physicsexamlab/dopplercart/(commit log)

2026-04-01 Add WIRELESS_RMS_START cmd and packet ACK mechanism
    - Send [0x37, 0x01, 0x00] to device service cmd char on connect
    - Subscribe to device service recv char for responses
    - Subscribe to both pos 0003 and 0004 chars
    - ACK periodic packets (data[0] <= 0x1F) by writing to pos 0005 char
2026-04-01 Fix: use GCMD_READ_ONE_SAMPLE [0x05,0x02] for position data
    Based on pasco-ble library analysis:
    - Smart Cart does NOT auto-stream; requires [0x05, 0x02] request per sample
    - Response format on 0003 char: [0xC0, 0x00, 0x05, lo, hi]
    - RawCountChange = int16LE(lo, hi), DataSize=2 (from datasheets.js)
    - Position = countAccumulated * 0.09895 / 816
    - sampleTick() now sends [0x05, 0x02] every 50ms
    - handlePositionNotify handles both one-shot and periodic formats
2026-04-01 Route dev recv notifications to handlePositionNotify
    Smart Cart sends all [0xC0,0x00,0x05,lo,hi] responses on device
    service recv char (4a5c0000-0003), not position service (4a5c0003-0003).
    Forward dev recv events to handlePositionNotify to decode position.
2026-04-01 Add combined Smart Cart + ESP32 freq sensor monitor (doppler.html)
    - Dual BLE: Connect Smart Cart (PASCO) + Connect Freq Sensor (ESP32) independently
    - ESP32 timestamp correction: t_recv - 37ms → sampling window center
    - Packet gap detection via ESP32 internal clock diff (>180ms = gap_ok:false)
    - Frequency chart (3rd canvas, orange) added alongside position/velocity
    - Linear interpolation merge: pos/vel interpolated at each freq timestamp
    - CSV: elapsed_s, pos_m, vel_ms, freq_hz, gap_ok (freq-first) or pos-only fallback
2026-04-01 Fix freq elapsed_s to use ESP32 internal clock (eliminate BLE jitter)
    - elapsed_s now computed as t_esp_s - firstFreqEspTime instead of
    browser receive time, removing ±15ms BLE connection interval jitter
    - t_true_ms (browser time) retained for position linear interpolation
    - firstFreqEspTime reset on startRecording() and resetAll()
2026-04-01 Fix CSV vel_ms: recompute from interpolated pos differences
    Previously vel_ms was interpolated from posSession velocities,
    causing inconsistency with the interpolated pos_m values.
    Now vel_ms = Δpos_m / Δelapsed_s using adjacent merged rows.
2026-04-01 Fix velocity: compute from notify arrival time instead of sampleTick timer
    Previously vel was calculated in sampleTick() using the 50ms timer
    timestamps, causing spikes when notify arrival and timer were misaligned.
    Now vel is computed in handlePositionNotify() using actual notify
    arrival times (Δpos / Δt), and sampleTick() reads latestVelocity directly.
2026-04-01 Fix CSV vel dip: interpolate vel_ms from posSession instead of Δpos/Δt
    When interpolated pos didn't change between freq samples (no notify
    in that window), Δpos/Δt produced false zero dips in vel_ms.
    Now vel_ms is interpolated directly from posSession.vel_ms which is
    computed at notify arrival time, avoiding the zero-dip artifact.
2026-04-01 Fix vel spikes: ignore notify dt < 20ms (devRecv/char0003 double-fire)
    Two BLE notify channels (devRecv + char0003) can deliver packets
    within 1-2ms of each other, causing dt≈0.002s and vel spikes of
    ±30 m/s. Now velocity is only updated when dt >= 20ms, treating
    sub-20ms arrivals as duplicate notifications.
2026-04-01 Fix CSV vel: use Δpos/Δt of interpolated pos, carry prev vel when Δpos≈0
    vel_ms now equals Δpos_m/Δt so pos and vel are numerically consistent.
    When interpolated pos is unchanged (no notify in window), the previous
    vel is carried forward to avoid zero dips.
2026-04-09 Fix CSV vel spikes/sticking: centered finite diff ±3pts; add amplitude column
    - Replace adjacent-point vel (60ms, carry-prev-on-zero) with ±3-point
    centered finite difference (~360ms window) to smooth notify jitter
    - Remove carry-prev-vel logic: Δpos=0 now correctly yields vel=0
    - Parse optional 3rd BLE field as amplitude in onFreqNotify/freqSession
    - CSV header: elapsed_s,pos_m,vel_ms,freq_hz,amplitude,gap_ok
2026-04-09 N=1600: double Goertzel window for better freq resolution
    - doppler-cart.ino: N 800→1600 (~110ms window @ 14.5kHz)
    - doppler.html: SAMPLING_TAIL_MS 37→67ms, FREQ_GAP_THRESHOLD_MS 180→360ms
2026-04-10 Reduce vel smoothing window: HALF_WIN 3→1 for better instantaneous velocity
    HALF_WIN=3 (±0.33s) averaged out rapid oscillations (~1Hz hand push),
    causing vel_ms to appear near-zero during actual fast motion.
    HALF_WIN=1 (±0.11s) better tracks instantaneous velocity.
2026-04-11 v5: Add AMPLITUDE_MIN for MAX9814, enable Serial output
    - Add AMPLITUDE_MIN=30.0f threshold (calibrate after MAX9814 connection)
    Fixes: audio-off noise passing MIN_PP check and generating spurious freq
    - freq_hz=-1 now when pp<MIN_PP OR amplitude<AMPLITUDE_MIN
    - Re-enable Serial.println for connection verification and calibration
    - Update comments for MAX9814 wiring (GAIN→VDD for 60dB, open for 40dB)
    [doppler-cart.ino]
2026-04-11 Fix MAX9814 GAIN pin comment: open=60dB (not 40dB)
    Per datasheet: GAIN=open→60dB, GND→50dB, VDD→40dB.
    Previous comment had it backwards.
    [doppler-cart.ino]
2026-04-11 Raise AMPLITUDE_MIN 30→50: noise floor max=28, need margin
    MAX9814 60dB measured: noise floor 2-28 counts, signal 460-610 counts.
    30 was too close to noise max (27.74). 50 gives comfortable margin.
    [doppler-cart.ino]
2026-04-19 Add amplitude filter, velocity smoothing, and Doppler scatter plot
    - doppler_55ms.html: amplitude threshold slider (default 100), 5-point
    trailing average for velocity display, scatter plot panel (v vs. Δf)
    with theoretical curve and auto-computed f₀
    - analyze_doppler.py: offline scatter plot analysis across 4 runs,
    amplitude threshold sweep (50/100/150/200)
    - Add scatter PNG outputs from 4-run dataset
2026-04-20 Add encoder reset to Reset button: BLE [0x05,0x01] + post-reset jump filter
2026-04-20 Improve measurement reliability: amplitude filter, continuity check, phase slip watchdog
    - AMPLITUDE_MIN 50→80 (firmware): eliminates spurious values from low-SNR zone
    - freq_scan continuity check (8Hz/frame threshold): rejects false room-mode peaks
    - Phase slip watchdog (5Hz scan-vs-phase threshold): detects and clears 2π slips
    - JS safety net: same filters applied client-side for legacy firmware compatibility
    - Chart: low-confidence freq_phase points (amp < 2×threshold) shown as gray dots
    [doppler-cart.ino]
2026-04-20 Revert firmware logic additions: keep only AMPLITUDE_MIN 50→80
    Continuity check and phase-slip watchdog removed from .ino to eliminate
    potential crash source. These filters remain active in JS (doppler-phase.html).
2026-04-20 Remove per-frame Serial output from loop()
2026-04-20 Split amplitude threshold: SCAN=80, PHASE=40
    Phase method derives frequency from phase difference Δφ, not peak amplitude.
    Lower threshold exploits its robustness to amplitude fading.
2026-04-20 Add physical range filter for freq_phase: |freq_phase - fc| > 10 Hz → -1
    Catches phase slips when freq_scan is also -1 (watchdog blind spot).
    10 Hz corresponds to v ≈ 3.4 m/s, beyond typical cart speed.
2026-04-20 Tighten physical range filter: 10 Hz → 6 Hz (v ≈ 2.1 m/s)
2026-04-21 Fix vel_ms accuracy: use BLE-timed velocity instead of position diff
    - buildCsv(): replace HWIN=1 position-difference recomputation with
    p.vel_ms from interpolatePos(), which reflects BLE arrival-timed
    velocity — eliminates spikes from stale/duplicate position packets
    - drawScatter(): same fix for both scan and phase scatter points
    (removed HALF_WIN=2 position-diff, now uses pi.vel_ms directly)
    - handlePositionNotify(): detect seq number gaps (mod-32) and log
    dropped PASCO BLE packets to Diagnostic Log
    - Track lastPositionNotifyMs on every position notify (stale detection
    groundwork)
2026-04-21 Revert vel_ms to position diff with HWIN=3 (330ms window)
    BLE-timing velocity (Fix 1) caused worse spikes (up to -4.45 m/s)
    due to burst packet arrivals with short Δt. Position diff over ±3
    frames (330ms) averages out stale/repeated positions while staying
    within physically reasonable bounds.
2026-04-21 Stabilize phase tracking and fix HTML amplitude gating
    ino changes:
    - TRACKING中の81点スキャンを停止（SCANNING/CAL_PHASEのみ実行）
    - TRACKING時のamplitudeをIQ振幅に切り替えてBLE送信
    - HOLD_MAX超過でCAL_PHASEに戻らずφチェーンリセット+f_estホールド継続
    - BLEコメントを8フィールド仕様に修正、TRACKINGの動作説明を実装と整合
    html changes (v2):
    - Scan/Phase振幅閾値を分離（scanAmpThreshold=100, phaseAmpThreshold=10）
    - gap_okをisScanPointUsable/isPhasePointUsableに統合
    - estimateStaticPhaseOffsetHzに速度フィルタ(|v|<0.08)を追加しΔφ₀診断を改善
    - amplitudeラベルをTRACKING時は"IQ amp"と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
2026-04-22 Fix PLL drift bug and add time axis to charts
    PLL: replace absolute phase wrap_pi(phi) with frame-to-frame dphi
    = wrap_pi(phi - prev_phi), converting to freq_error via 2π×T_el.
    Drops PI loop (KP/KI) in favor of simple IIR (PLL_ALPHA=0.20) per
    original design intent. Eliminates spurious f_est drift while stationary.
    HTML: add second-tick time axis to position, velocity, and frequency
    charts. Data plotted on time-linear x-axis using parallel elapsed_s
    arrays (posTimeValues / freqTimeValues).
2026-04-23 Add simplified PLL firmware and fix HTML reference-line inconsistencies
    New files:
    - Arduino/doppler-cart-phase-simple/doppler-cart-phase-simple.ino
    v3 PLL: Goertzel probes f_est (not fc), no Goertzel calibration scan,
    nominal 1000 Hz start, NCO phase continuity across frames.
    - doppler-phase-simple.html
    Companion UI: auto-zeros f_c from static interval via Smart Cart velocity.
    Bug fixes in doppler-phase-simple.html:
    - Freq chart reference line now uses getReferenceFc() (= derivedFc when
    available) instead of lastFc (firmware nominal 1000 Hz), so it matches
    the scatter plot's Δf=0 baseline.
    - freq_phase range check now uses freq_pll as reference when PLL is lock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
2026-04-24 Add files via upload
    低振幅の freq_pll をそのまま採用・描画しない安全網
2026-04-25 Improve doppler_55ms.html: shared time axis, Goertzel quality fixes
    - Add drawTimeAxis() and shared-time-axis label below freq chart,
    matching doppler-phase-simple.html layout
    - Track posTimeValues/freqTimeValues rolling buffers; pass to all
    three chart draw calls (pos, vel, freq) so x-axis shows elapsed_s
    - Raise AMPLITUDE_MIN threshold to 100 to match HTML slider default
    and suppress spurious outlier reads (980 Hz, 1009 Hz) from low-SNR windows
    - Compute t_esp_s at window midpoint (t0+t1)/2 instead of post-Goertzel
    micros(); set SAMPLING_TAIL_MS=0 accordingly
    - Add NimBLEDevice::setPower(ESP_PWR_LVL_P9) for BLE range
    - Wrap Serial.println under #define DEBUG_SERIAL 0
    - Add gap_ok c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
2026-04-25 Fix velocity quality in doppler_55ms.html to match phase-simple
    - SAMPLING_TAIL_MS: 0 → 37ms
    - CSV_VEL_HALF_WIN: 1 → 3 (±3 frames ≈ 330ms window)
    - t_true_ms: use firstFreqRecvMs + elapsed_s*1000 anchor to eliminate
    BLE jitter, consistent with doppler-phase-simple.html approach
    - Add firstFreqRecvMs state variable with proper resets
2026-04-25 Add amplitude²-weighted frequency averaging to chart, stats, and CSV
    - computeWeightedFreq(): amplitude²-weighted mean over ±FREQ_W_HALF_WIN(=3) frames
    - drawFreqChart(): raw freq as faint line, weighted avg as bold line (replaces drawChart call)
    - CSV: add freq_w_hz column (central ±3 window, matching vel_ms window)
    - Display stats: show weighted freq instead of raw last value
    - resetAll(): clear freqWValues buffer
2026-04-26 Sync position sampling to ESP32 timestamp in onFreqNotify
    posSession was previously populated by setInterval(55ms), causing
    t_ms to reflect browser poll time rather than when the Smart Cart
    position was actually measured. This mismatch introduced timing
    jitter into interpolatePos, making differentiated velocity noisy.
    Now posSession is pushed inside onFreqNotify using t_true_ms (ESP32
    internal clock, BLE-jitter-corrected), so position and frequency
    share the same timebase. sampleTick is reduced to a keepalive-only
    0x05/0x02 write for the Smart Cart stream.
2026-04-26 Record posSession event-driven from handlePositionNotify
    The previous fix moved posSession sampling into onFreqNotify, which
    correctly aligned timestamps to the ESP32 clock but did not fix the
    zigzag velocity problem. The root cause was that latestPosition does
    not change when the Smart Cart sends no notification in a 55ms window,
    causing alternating zero/double-size position jumps (~19% of frames).
    Now posSession is populated inside handlePositionNotify using the BLE
    notification arrival time (performance.now()) as the timestamp. This
    gives one posSession entry per actual Smart Cart position update, at
    the true measurement time. interpolatePos then correctly interpolates
    between these even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
2026-04-26 Exclude Goertzel boundary hits from freq weighted average; add devlog
    computeWeightedFreq now skips frames where freq_hz is at or beyond
    the Goertzel search range boundaries (960 Hz / 1040 Hz). These
    boundary-pinned values are spurious hits that occur at low amplitude
    and can inflate the window spread by up to 54 Hz, even though amp²
    weighting already suppresses their contribution significantly.
    Also adds GOERTZEL_FREQ_LOW/HIGH constants matching Arduino firmware,
    and DEVLOG_2026-04-26.md summarising today's signal quality work and
    two-stage position timestamp synchronisation fixes.
2026-04-26 Use freq_w_hz in scatter plot and on resize/slider redraw
    Three fixes:
    1. drawScatter: Δf was computed from raw f.freq_hz. Now uses
    computeWeightedFreq(..., FREQ_W_HALF_WIN) so scatter points
    reflect the smoothed, outlier-suppressed frequency. Frames with
    no valid weighted average (fw <= 0) are skipped.
    2. resizeCanvases: was calling drawChart(freqValues) which only
    rendered raw freq_hz without the weighted overlay. Now calls
    drawFreqChart(freqValues, freqWValues, ...) matching the
    real-time rendering path.
    3. ampSlider handler: rebuilt freqValues/freqTimeValues but not
    freqWValues, then called drawChart instead of drawFreqChart.
    Now rebuilds all three buffers usi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
2026-04-27 Fix 7 bugs in doppler-cart-n800 firmware and doppler_55ms HTML monitor
    Firmware (doppler-cart-n800.ino):
    - Boundary-hit fix: bestB at bin 0 or N_BINS-1 now returns freq_hz=-1
    instead of outputting FREQ_LOW/FREQ_HIGH as if valid
    HTML (doppler_55ms.html):
    - Remove undeclared `notifyPacketCount` variable from resetAll()
    - Fix SAMPLING_TAIL_MS comment inconsistency (≈40ms → ≈37ms)
    - computeFRef() fallback: use median of all valid freqs instead of
    hardcoded 997.0 when no stationary data is available
    - Scatter plot: apply ampThreshold to gap_ok=false points (were shown
    red regardless of amplitude; now faint gray below threshold)
    - Standardize amplitude null-guard from `|| 0` to `?? 0`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
2026-04-27 Fix TypeError crash in connectSmartCart() after diagLog element removal
    document.getElementById('diagLog').textContent was called without a null
    check, but the diagLog element was removed from the HTML in a876047.
    This caused a TypeError on button click, preventing the BLE pairing
    dialog from appearing.
2026-04-27 Add doppler_55ms_spectrum.html: binary Goertzel spectrum receiver
    New companion HTML for the upcoming doppler-cart-n800-spectrum.ino
    firmware, which sends the full 81-bin Goertzel magnitude spectrum
    (960-1040 Hz, 1 Hz steps) over BLE on every 55 ms cycle to debug
    frequency-estimation outliers.
    Wire format (178 B per notify, little-endian):
    0..3 float32 t_esp_s (window-center seconds)
    4..7 float32 freq_hz (-1.0 if invalid)
    8..11 float32 amplitude
    12..15 float32 mag_scale (1 LSB of mag_q[] in mag units)
    16..177 uint16[81] mag_q (mag[b] = mag_q[b] * mag_scale)
    mag_scale is recomputed each frame as max(mag)/65535 so the uint16
    range tracks th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
2026-04-28 Record freq and pos timestamps separately in spectrum CSV
    - CSV now writes freq_t_s (window midpoint, SAMPLING_TAIL-corrected)
    and pos_t_s (BLE arrival, uncorrected) as separate columns so the
    freq vs pos timing alignment can be validated offline
    - pos column uses the nearest pos sample (no interpolation onto freq grid)
    - vel_ms is computed from pos's own t_ms central diff (±3 pos samples),
    removing the freq-grid interpolation that acted as a low-pass filter
    - Scatter plot uses the same pos-time central diff for consistency
    - Add nearestPosIdx() and posCentralDiffVel() helpers
2026-04-28 Sync pos polling to freq notify; widen vel window to fix slope bias
    - onFreqNotify now triggers [0x05,0x02] pos poll on every freq packet
    arrival, replacing the independent setInterval(55ms) as the primary
    polling source. This eliminates setInterval timer jitter (measured
    std=23ms) so pos_t_s becomes freq_recv_t + BLE_RTT (a near-constant
    offset), enabling future SAMPLING_TAIL_MS calibration.
    - sampleTick() now no-ops when freq sensor is connected; it remains as
    a fallback for cart-only mode (freq sensor absent).
    - CSV_VEL_HALF_WIN: 3 -> 6. Re-fit analysis on apr28_2.csv showed that
    the -9% slope deficit (2.65 vs theoretical 2.91 Hz/(m/s)) is caused by
    freq-vel time misalignme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
2026-04-28 Add SAMPLING_TAIL_MS in-browser calibration (τ-scan)
    Stop 後に τ ∈ [-80,+80] ms を 2 ms 刻みでスキャンし、
    v vs Δf の Doppler 線形フィット R² を最大化する τ_opt を求める。
    結果を calibPanel に表示し「適用」ボタンで samplingTailAdjMs を設定、
    drawScatter / buildCsv の freq-pos 時刻マッチングに即時反映する。
    ・calibrateSamplingTail(): τスキャン + 線形回帰 (nPts≥10 のみ採点)
    ・showCalibResult(): τ_opt / 推奨 SAMPLING_TAIL / R² / slope/理論 を表示
    ・stopRecording(): 自動校正呼び出し追加
    ・resetAll(): samplingTailAdjMs=0 + panel 非表示
    ・buildCsv() / drawScatter(): adjTrueMs = t_true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
2026-04-28 Replace nearestPosIdx with linear interpolation for freq-pos matching
    pos_m と vel_ms を freq_t_true 前後 2 点の線形補間に変更。
    nearestPosIdx（最近傍選択）を削除し interpolatePos(t, halfWin) に統一。
    pos_t の ±24ms BLE RTT ジッターによる Doppler slope 誤差を軽減する。
2026-04-28 Fix calibrateSamplingTail: revert to nearestPosIdx for tau scan
    interpolatePos(halfWin=6) は ±180ms 平均速度を返すため、
    ±80ms の τ スキャンで速度がほぼ変化せず R² が flat になり
    境界値 (+80ms) に張り付く問題があった。
    calibrateSamplingTail 専用に nearestPosIdx を復元し、
    posCentralDiffVel(k, HALF) を使う元の方式に戻す。
    drawScatter / buildCsv は引き続き interpolatePos を使用。
2026-04-29 Add 2kHz variants: doppler-cart-n800-spectrum-2k.ino and doppler_55ms_spectrum_2k.html
    Goertzel band shifted from 960-1040 Hz to 1960-2040 Hz.
    BLE device name changed to "Doppler Spec Sensor 2k".
    Scatter plot Y-axis widened to ±20 Hz (doubled Doppler shift at same velocity).
    All other logic identical to the 1kHz originals.
2026-04-29 Switch pos to 100Hz burst streaming via 0003-0004
    - Subscribe to POSITION_BURST_CHAR (0003-0004) for high-rate streaming
    - Send rate cmd (01 10 27 00 00 02 00) to set 100Hz before WIRELESS_RMS_START
    - Change 37 01 00 → 37 01 01 to enable streaming mode
    - Replace handlePositionNotify (one-shot poll) with handlePosBurst (burst parser)
    - Add carry-byte buffer to handle odd-byte ATT payloads at 100Hz (20-byte MTU limit)
    - Fix ACK format: 5 bytes [00 00 00 00 seq] matching SPARKvue protocol
    - Remove 05 02 one-shot polling from onFreqNotify and sampleTick
    - Reduce CSV_VEL_HALF_WIN 6 → 3 (pos now 10x denser at 10ms intervals)
    - Remove DUPLICATE_GUARD_MS (no longer needed without one-shot polls)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
2026-04-29 Add start trigger (0x00) to devCmd after WIRELESS_RMS_START
    37 01 01 arms streaming mode but does not start data flow.
    SPARKvue sends 0x00 to devCmd as the actual start trigger,
    after which 0003-0004 burst notifications begin.
2026-04-29 Add 05 10 query and 06 af 05 experiment config before start trigger
    Replicating SPARKvue 100Hz sequence:
    37 01 01 (arm streaming)
    05 10 (pos status query / rate commit)
    06 af 05 (experiment config, value from 100Hz capture)
    00 (start)
    Previous attempts (37 01 01 + 00 alone) produced no 0003-0004 bursts.
2026-04-29 Fix seq wrap: use 5-bit counter (mod 32) not mod 256
    Cart seq is 0x00..0x1f (32-cycle). Using & 0xFF caused
    0x1f→0x00 normal wrap to be reported as 224 lost packets,
    which incorrectly cleared posBurstCarry on every cycle.
2026-04-29 Fix pos timestamp: sequential clock to reduce BLE jitter propagation
    - Replace per-burst t_recv backtrack with sequential lastSampleEndTime+10ms
    - Re-anchor to t_recv only when drift exceeds ±2 sample periods (20ms)
    - Reset sequential clock on seq gap and startRecording/resetAll
    - Clarify posBurstCarry comment: carry is 100Hz-specific (20/50Hz have even payloads)
    - Add warning comment on 06 af 05 middle byte variability (20Hz=ac, 50Hz=ad, 100Hz=af)
2026-04-29 Fix P1: don't reset decoder state at startRecording; add burst watchdog
    P1 (critical): Remove posBurstCarry=[] and lastSampleEndTime=0 from
    startRecording(). Recording start is purely a data-saving boundary —
    the 100Hz burst decoder runs continuously and resetting carry mid-stream
    shifts int16 parsing by 1 byte, corrupting countAccumulated permanently.
    P2b: Add 2s watchdog after start trigger. If lastPacketSeq hasn't
    advanced, log a warning that 06 af 05 middle byte may need adjustment.
2026-04-30 Widen tau scan to ±200ms; warn on rawChange spikes
    calibrateSamplingTail() の探索幅 ±80ms では実測の最適 τ ≈ -130ms を
    拾えず境界に張り付いていたため ±200ms に拡大。
    handlePosBurst() で |rawChange| > 200 cnt/10ms (≈ 2.4 m/s) のときに
    seq / sample index / carry / payload 長を warn 出力し、100Hz burst
    parser の byte misalignment 疑いを切り分けられるようにする。
2026-04-30 Push pos/vel chart at 100Hz from handlePosBurst
    freq notify (~18Hz) で latestPosition / latestVelocity をスナップ
    していたため、pos burst 間隔 (~10Hz, 9-10サンプル/notify) との不整合
    で 1-2 freq frame の値が同じになり、グラフが階段状に見えていた。
    handlePosBurst の per-sample ループで posValues / velValues /
    posTimeValues に直接 push し、バースト末尾で 1 度 drawChart する。
    描画レートはバースト rate (~10Hz) に保ちつつ、サンプル粒度は 100Hz
    となるため、定常運動で滑らかな直線が出るはず。階段が残るなら
    100Hz parser の正しさを疑う段階に進む。
    CSV 経路 (interp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
2026-04-30 Fix stop button: gate 100Hz display push with isRecording
    handlePosBurst chart push block was not guarded by isRecording,
    so charts continued updating after stopRecording() was called.
2026-04-30 Quiet console after Stop; flag BLE stalls; explicit stop log
    - Gate handlePosBurst diagnostic warns (seq gap, clock re-anchor, rawChange
    spike) behind isRecording so the console goes silent after Stop. The BLE
    notify pipe stays subscribed by design, but the unconditional warn flood
    made it look like recording was still active.
    - Suppress normal-jitter re-anchors (≤50ms) and call out |drift|>200ms as
    a distinct "BLE stall" with a counter, so the 1.6s stall-and-burst event
    seen in apr30_4 is unambiguous instead of buried in re-anchor noise.
    - log() "Recording started." / "Recording stopped." with frame counts and
    stall summary, and guard stopRecording() against double-execution.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
2026-04-30 Feature B: per-frame spectral quality metrics + UI indicator + frame filter
    Add sidelobe_ratio and fwhm_hz metrics computed from each Goertzel spectrum
    frame's mag_q array to detect multipath interference in real time.
    - computeSpecQuality(): sidelobe_ratio (secondary peak / primary peak, outside
    ±10 Hz exclusion zone) and fwhm_hz (half-power width of primary peak)
    - updateQualityIndicator(): GOOD/MARGINAL/POOR badge with color, updated every
    freq notify; threshold at sidelobe_ratio < 0.50 / 0.75 / ≥0.75
    - Quality bar UI: real-time badge + sidelobe/FWHM detail + "Filter poor quality"
    checkbox (default OFF)
    - drawScatter(): poor frames (sidelobe ≥ 0.75) rendered as dim orange; whe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
2026-05-01 Fix: Unify graph time axes (t=0 to stop time) and add freq_hz validation
    - Increase MAX_POINTS from 300 to 3000 to prevent data deletion before recording stops
    - Add recordEndTime_s global variable to track recording end time
    - Unify time axis across all three graphs (Position, Velocity, Frequency):
    * Left edge: always t=0 (start of recording)
    * Right edge: recordEndTime_s (time when Stop button pressed)
    - Stop button now redraws all graphs with unified time axis
    - Add mag_idx_max to CSV export: the frequency bin index with maximum magnitude
    * Allows validation of freq_hz values against actual spectral peak
    * Format: frequency value corresponding to the max magnitude bin
    This resolv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
2026-05-01 Fix: Use freq_t_s instead of elapsed_s for frequency graph time axis
    The on-screen frequency graphs were using elapsed_s (ESP32 internal clock)
    as the time axis, while the CSV export used freq_t_s (corrected with
    SAMPLING_TAIL calibration). This mismatch caused:
    1. Visual kinks at t≈2.1s and t≈3.5s where the relationship between
    elapsed_s and actual timing changed
    2. Time coordinate offset: freq_t_s < elapsed_s by ~40-130ms
    Both live drawing (handleFreqNotify) and post-recording rebuildFreqBuffers()
    now calculate freq_t_s = (t_true_ms + samplingTailAdjMs - recordStartTime)/1000
    to match CSV output and provide correct visual alignment.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
2026-05-01 Fix: Align frequency graph time axis with position/velocity graphs
    The frequency graph was using recordStartTime as the time reference, while
    position and velocity graphs used firstFreqRecvMs. This caused a horizontal
    offset between the graphs when recordStartTime and firstFreqRecvMs differed
    (typically 0-500ms apart).
    Changed frequency time axis calculation to use firstFreqRecvMs as the base
    reference (same as position/velocity), ensuring all three graphs display
    on the same unified time scale:
    freq_t_chart_s = (adjTrueMs - firstFreqRecvMs) / 1000
    This affects both live display (handleFreqNotify) and post-recording
    rebuild (rebuildFreqBuffers). CSV export remains independent with
    record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
2026-05-01 Fix: Improve spectral quality filter and τ calibration robustness
    1. QUALITY_EXCLUSION_HZ: 10.0 → 20.0 Hz
    - Hann window main lobe FWHM ≈ 40Hz に対応
    - sidelobe_ratio = 0.82-0.83 の実測値を正しく評価
    - フィルタ動作: 全フレーム除外 → 上位15%のみ除外に改善
    2. calibrateSamplingTail() 改善
    - Adaptive amplitude threshold (中央値の60% or 200)
    - 固定300 hardcode → データ依存的な閾値に改善
    - Quality filter: 0.75 → 0.85 (Hann tail を超える不良のみ除外)
    - τ calibration が amplitude に依存しすぎる問題を軽減
    Result:
    - may1_5.csv で "Filter poor quality" が正常に機能
    - τ run-depen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
2026-05-01 Feature: Per-session τ auto-calibration and reset
    1. UI: Update scan range description ±80ms → ±200ms (already impl'd in code)
    2. UI: Add "Auto-apply τ" checkbox (default checked) in calibration panel
    3. Auto-apply: showCalibResult() now auto-applies τ_opt if checkbox is checked
    4. Reset: startRecording() now resets samplingTailAdjMs=0 to discard previous session's τ
    Rationale: apr30_2 τ_opt=-130ms exceeded ±80ms range; ±200ms scan accommodates
    run-dependent variance. Auto-apply removes manual step; startRecording() reset
    prevents stale τ carryover between sessions without explicit Reset button.
    Expected improvement: may1_6 negative slope (-7.22 Hz/(m/s)) for high-speed
    region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
2026-05-01 Fix: Disable τ auto-calibration, use fixed value τ = -40 ms
    Problem: commit 1557a21's auto-calibration converges to local optima
    - apr30_2: τ = -130 ms (boundary saturation)
    - apr30_3: τ = -40 ms (improved)
    - may1_7: τ = +86 ms (sign reversed, Doppler slope became negative!)
    Root cause: calibrateSamplingTail() optimizes R² without checking slope sign
    - Low SNR (5.51) → noisy frequency data
    - High sidelobe (0.50) → spectrum is broad
    - Multiple local optima exist with different slope signs
    - R² maximization selects physically wrong τ
    Solution: Use fixed τ = -40 ms (empirical value from apr30_3)
    - Stable across sessions
    - Allows students to measure real Doppler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
2026-05-14 Add firmware flashing page and binary files
    - flash.html: browser-based firmware installer using ESP Web Tools
    - firmware/: bootloader, partitions, boot_app0, application binary
    (Arduino Nano ESP32 / ESP32-S3, flash-mode dio 80m)
2026-05-14 Clean up obsolete files, update firmware source
    Remove old HTML prototypes, .md handoffs, old Arduino sketches,
    and PNG artifacts. Keep only doppler-cart.html, flash.html,
    Arduino/doppler-cart/, and firmware/.
2026-05-14 Add detailed firmware flashing procedure to README
    Document manual ROM bootloader entry (B0–GND jumper + USB reconnect)
    required because Arduino Nano ESP32 lacks USB-UART bridge.
2026-05-15 Add simpler LED-watch flashing method as primary procedure
    The Arduino UF2 bootloader's double-reset detection makes a jumper
    wire unnecessary on macOS: connect USB, then press RESET once during
    the 1-2 second window while the green LED is on. The B0-GND jumper
    method is kept as a fallback.
2026-05-15 Simplify firmware flashing instructions in README
    Remove alternative B0-GND jumper method, ROM bootloader verification
    section, and troubleshooting section. Keep only the clean 8-step LED
    (double-reset) method with simplified heading.
2026-05-15 Prepend UTF-8 BOM to CSV download to fix Excel mojibake
    Excel (especially Japanese version) defaults to Shift-JIS when opening
    CSV files without a BOM, garbling the Japanese header
    (時間/位置/速度/周波数/振幅). Adding U+FEFF at the start of the Blob
    forces Excel to recognize the file as UTF-8.
2026-05-15 Revoke Stage 2a-r1 drop-aware logic
    The drop_delta>0 → theta_valid=false + freq_hz=-1 block invalidation
    introduced in Stage 2a-r1 (2026-05-11) caused HTML-side tracking_break
    clusters that lost 2-5 frames per drop, preferentially eliminating
    high-v frames and compressing the Doppler slope.
    A/B test (2026-05-15) showed slope recovery 4.10 → 5.17 Hz/(m/s),
    R² 0.64 → 0.92, with multi-frame gap clusters 8 → 0. Static σ remained
    0.10 Hz (DMA accuracy preserved).
    Changes:
    - Remove drop_delta computation + theta_valid=false in firmware (3 sites)
    - Simplify BLE diag word back to plain uint32 dt_us
    - Rebuild firmware/firmware.bin (Arduino IDE 1.2.0, esp32 3.3.8, NimBLE 2.5.0)
    - Document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
2026-05-16 Use readable local-time CSV filename
    CSV のダウンロードファイル名を doppler_iq_<UTC ISO>.csv から
    doppler_<ローカル時刻 YYYY-MM-DD_HHMMSS>.csv に変更。
    - "_iq_" は IQ 法導入時の旧版区別用で現在は不要なため削除
    - toISOString() の UTC 表記は日本時間と 9 時間ずれて分かりにくいため
    ローカル時刻のゲッターに変更
    - T/Z/ミリ秒の機械向け表記を排し、日付と時刻が一目で読める形式に
2026-05-16 Add per-device BLE name suffix from MAC for classroom use
    Append the Bluetooth MAC last 2 bytes to the BLE device name
    ("Doppler IQ Sensor XXXX") so multiple carts in one classroom are
    distinguishable in the Web Bluetooth chooser. Print the name on the
    boot serial line and document the labeling step in flash.html.
    Rebuilt firmware.bin reflects the new naming.
2026-05-16 Advertise BLE device name via scan response
    NimBLE 2.5.0 does not auto-inject the GAP name from init() into the
    advertisement, so the per-device "Doppler IQ Sensor XXXX" name was
    never broadcast and the Web Bluetooth chooser fell back to a stale
    OS-cached name. Call pAdv->setName() after enableScanResponse(true)
    so the complete name is carried in the scan response. Rebuilt
    firmware.bin reflects the fix.
    [doppler-cart.ino]
2026-05-17 Use public BLE address and add firmware build banner
    macOS CoreBluetooth welds a cached GAP name to a peripheral's
    identity, so the per-device name never showed in the chooser on
    machines that had connected under the old firmware. Advertise from
    the chip's unique public MAC (setOwnAddrType public) instead of a
    random address, place the Complete Local Name in the primary
    advertising PDU, and print a build-unique serial banner (FW_REV +
    __DATE__/__TIME__ + addr) so the running firmware is verifiable.
    Validated on a clean client (iPad nRF Connect shows
    "Doppler IQ Sensor AFA1"). Rebuilt firmware.bin (r6).
2026-05-17 Rename "IQ Sensor" UI text to "Freq Sensor"
    "IQ" was a development-era term that students don't understand, and
    the report already documents the button as "Connect Freq Sensor".
    Rename the connect button and the user-visible log messages to match;
    the advertised BLE name ("Doppler IQ Sensor XXXX") is intentionally
    left unchanged as it is not prominent to students.
2026-05-17 Make charts viewport-responsive and print-friendly
    - Canvas heights now adapt to the browser viewport in resizeCanvases()
    (live chrome measurement, weighted distribution, legibility minimums);
    position/velocity/frequency stay vertically stacked sharing the time
    axis, scatter moves beside them on wide screens and below on narrow.
    - Merge the 4 stat cards + signal-quality into one info-strip row and
    add short-viewport chrome compaction to reclaim vertical space.
    - Remove cosmetic backgrounds for print contrast: white canvas/page
    background, drop the decorative grid overlay and backdrop blur.
    - Warn before BLE pairing when macOS native fullscreen would push the
    Chrome device chooser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
2026-05-18 Flip Doppler theory sign for x>0 launch and drop volume hint
    Cart is now pushed in +x direction, so the low-speed Doppler
    approximation becomes Δf = -f₀·v/vₛ; theory curve and label
    updated accordingly. Also removed the speaker-volume hint text,
    which wrapped on Chromebook and pushed charts off-screen.
2026-07-25 Keep Smart Cart 100Hz position stream alive by co-streaming aux services
    Position-only streaming stalls after ~1.0s (12 packets) on both test
    carts (ME-1240, ME-1241) regardless of ACK format/cadence. Arming and
    subscribing to Force/Accel/Gyro alongside Position — and ACKing their
    bursts — keeps the stream continuous (10s+ verified on both carts).
    This matches SparkVue's own BLE traffic, captured via DevTools.
    Also handles the cart's retransmission flag (bit 7 of the burst seq
    byte), which was silently double-counting samples, and serializes GATT
    writes to the cart to avoid "operation already in progress" failures.
2026-08-13 Output raw firmware frequency, guarded by the theta-regression
    The theta-regression is now an outlier detector, not the published value.
    14 runs (10 on 2026-08-13 with the source on the cart, 4 from 08-12)
    show the theta-regression shaves 1-3% off the Doppler slope, consistent
    in 13 of 14 runs (p=0.0018). The deficit survives every amplitude cut
    and shows up on constant-velocity plateaus alone, so it is not caused by
    low-amplitude frames or by filtering across the acceleration ramps.
    Recovery (= 348.3 / apparent sound speed), 14 runs:
    theta-regression 0.961 +/- 0.019 (worst 0.925)
    raw 0.972 +/- 0.040 (worst 0.842)
    raw + 8 Hz guard 0.980 +/- 0.018 (worst 0.945)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
2026-08-25 Copy TSV to the clipboard instead of CSV
    Pasting comma-separated text into Excel or Sheets lands everything in
    column A and needs a "text to columns" step. Students hit this first,
    before any physics. Tab-separated text pastes straight into columns.
    The button labels now say what they do: 表計算に貼り付け（コピー）and
    CSV保存. buildCsv() is untouched, so the download path is unchanged;
    values never contain a comma, so the split/join is safe. Falls back to
    a hidden textarea plus execCommand when the clipboard API is missing.
    Same shape as tracking_analysis_for_physics_v2.html.
2026-08-27 Save the on-screen results as a PNG next to the CSV
    High-school students asked for a way to keep what the app shows on
    screen; not all of them know how to take a screen capture, so put an
    explicit button in the UI.
    - 画像保存 button next to CSV Export, both grouped at the right end.
    - Modal mirrors the CSV one: preview + [画像をコピー][画像を保存],
    with a range selector (全部 / 散布図だけ / 時系列だけ).
    - The image is composed offscreen at a fixed layout rather than copying
    the screen: canvas aspect ratios follow the window size, so a screen
    dump would give every student a differently shaped figure. It carries
    a header band (title / filename / timestamp) a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
